Olexa9dra/stm32-binary-clock/docs/board_photos/power_and_stm32_back.jpg

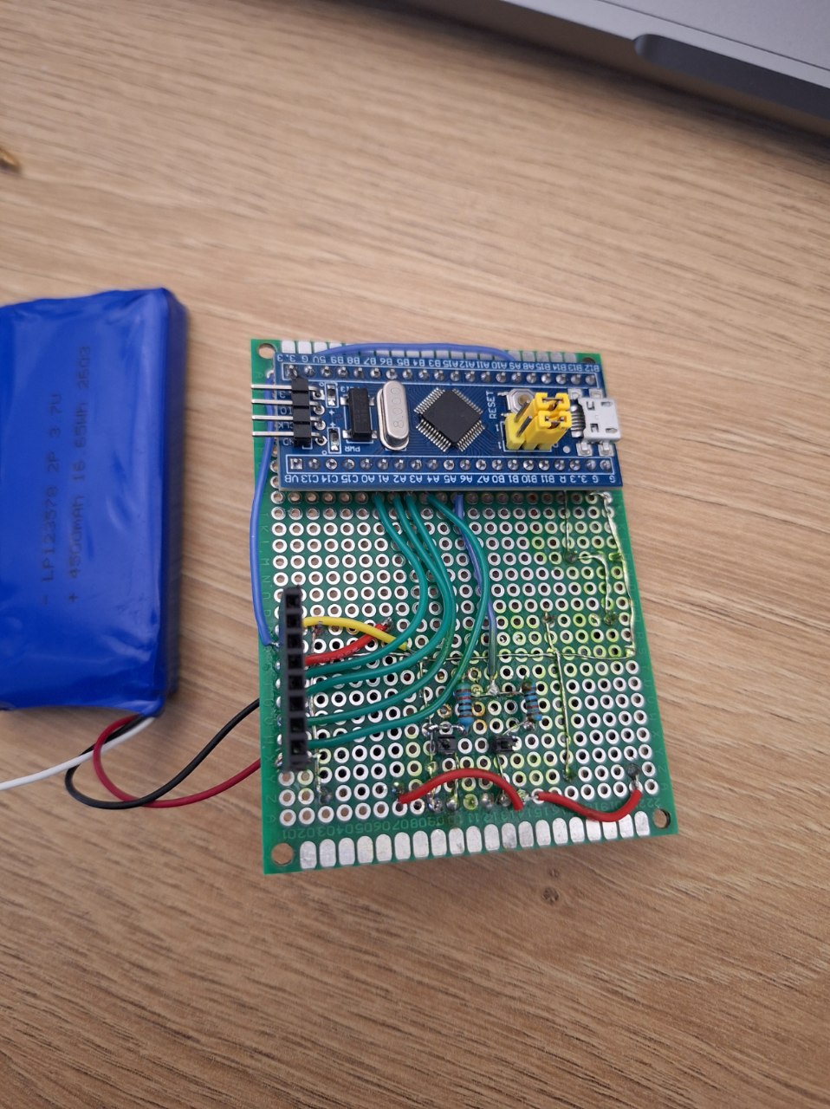
docs/board_photos/power_and_stm32_back.jpg
