Olexa9dra/stm32-binary-clock/docs/board_photos/periphery_front.jpg

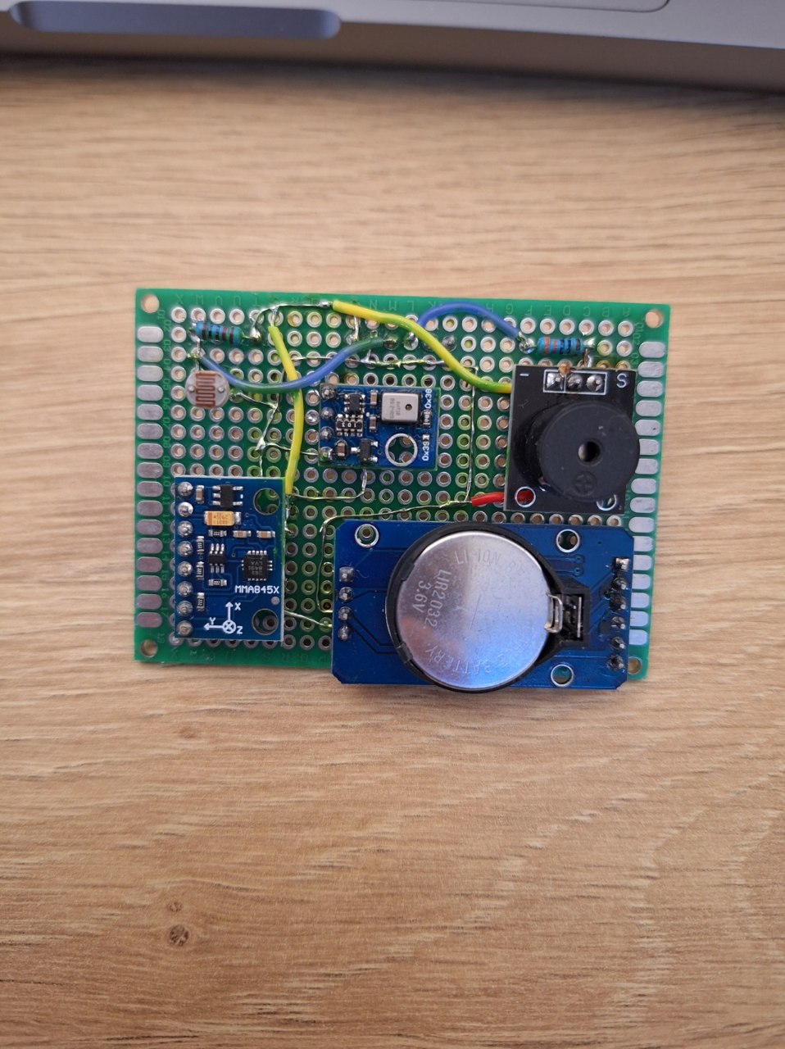
docs/board_photos/periphery_front.jpg
