Olexa9dra/stm32-binary-clock/docs/freecad_model.png

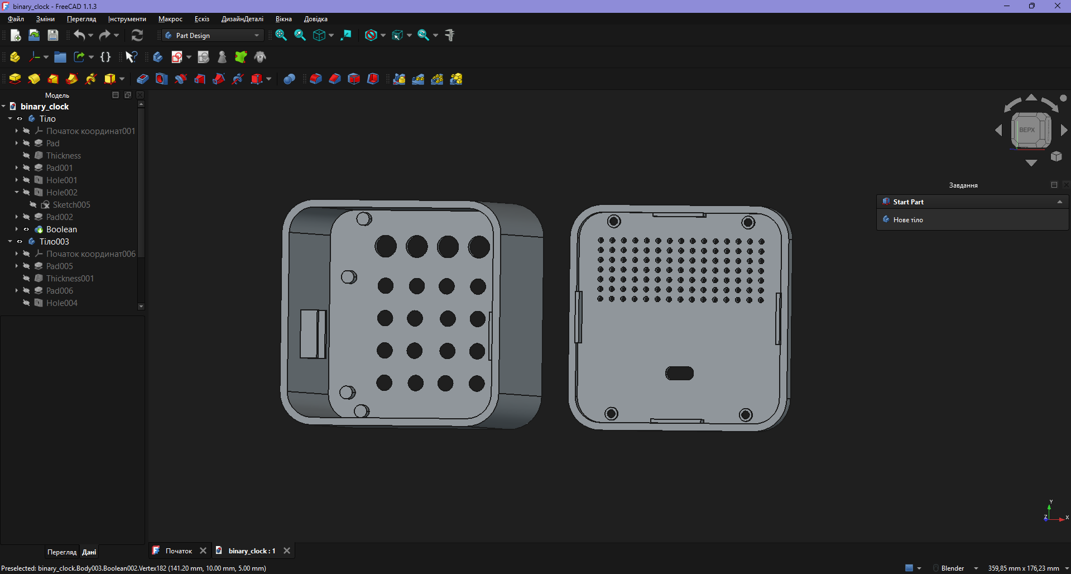
docs/freecad_model.png
