Olexa9dra/stm32-binary-clock/docs/kicad_schemes.png

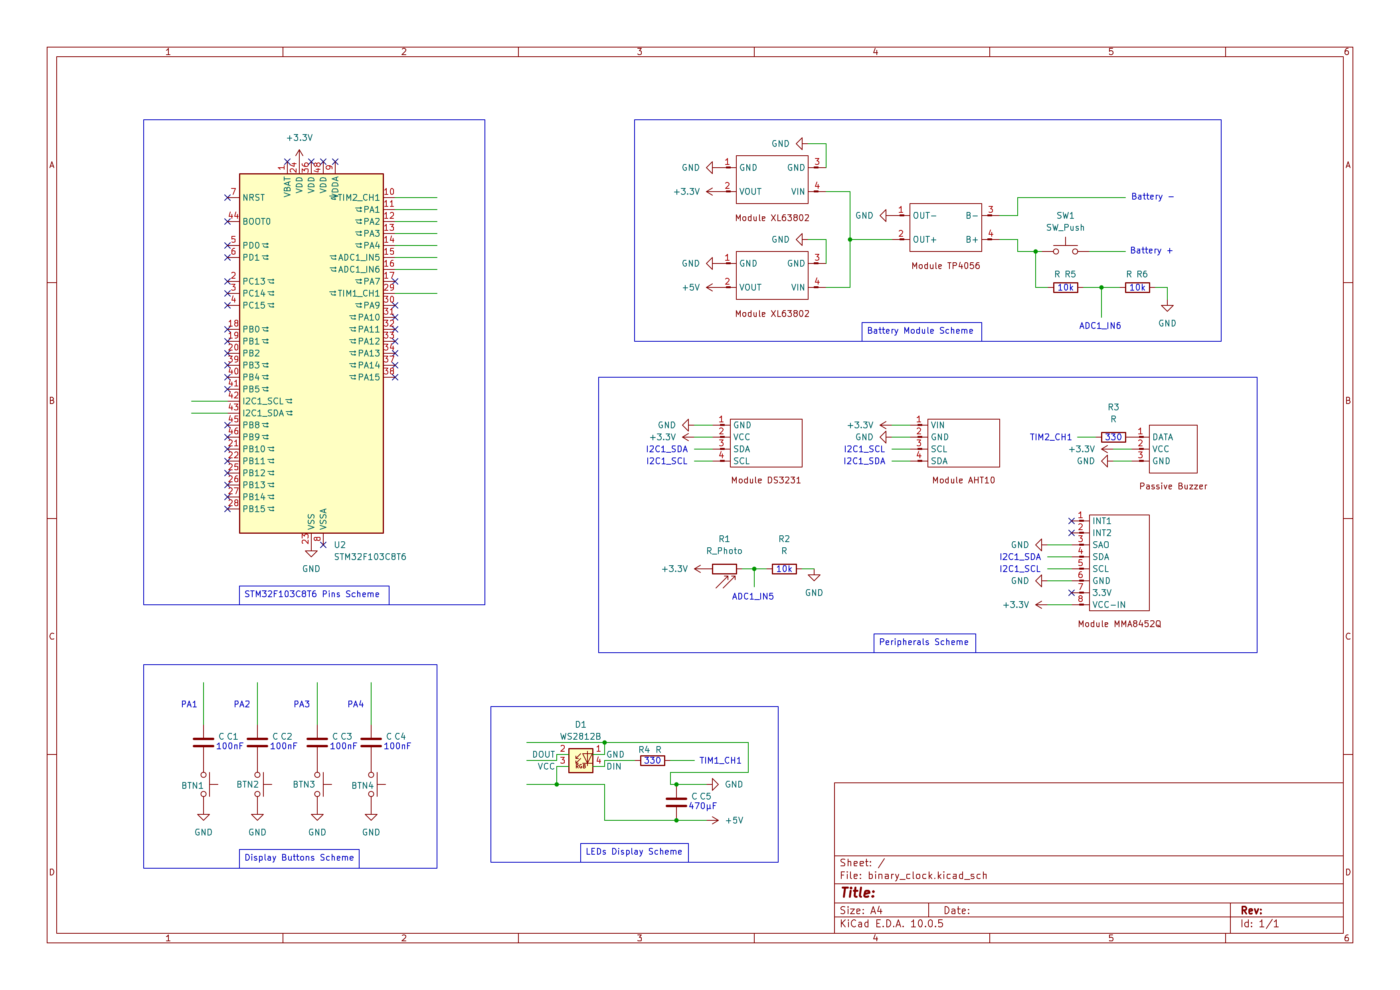
docs/kicad_schemes.png
