Olexa9dra/stm32-binary-clock/BinaryClock-F103.ioc

Mcu.UserName=STM32F103C8Tx
PA0-WKUP.Signal=S_TIM2_CH1_ETR
PA1.Signal=GPIO_Input
PA13.Signal=SYS_JTMS-SWDIO
PA14.Signal=SYS_JTCK-SWCLK
PA2.Signal=GPIO_Input
PA3.Signal=GPIO_Input
PA4.Signal=GPIO_Input
PA5.Signal=ADCx_IN5
PA6.Signal=ADCx_IN6
PA8.Signal=S_TIM1_CH1
PB6.Signal=I2C1_SCL
PB7.Signal=I2C1_SDA
