Olexa9dra/stm32-binary-clock/Drivers_Custom/Inc/light_sensor.h

#ifndef LIGHT_SENSOR_H
#define LIGHT_SENSOR_H

#include <stdint.h>

#define ADC_MIN 800
#define ADC_MAX 2500
#define BRIGHTNESS_MIN 2
#define BRIGHTNESS_MAX 20
#define UPDATE_DELAY_MS 100
#define ADC_POLL_TIMEOUT_MS 1U
#define BRIGHTNESS_HYSTERESIS 10

void LightSensor_Init(void);
void LightSensor_Update(void);
uint8_t LightSensor_GetBrightness(void);

#endif
