Olexa9dra/stm32-binary-clock/Modules/Inc/environment.h

#ifndef __ENVIRONMENT_H
#define __ENVIRONMENT_H

#include <stdint.h>

#define ENVIRONMENT_UPDATE_INTERVAL_MS 30000U

void Environment_Init(void);
void Environment_Update(void);
uint16_t Environment_GetDisplayValue(void);

#endif
