Olexa9dra/stm32-binary-clock/Modules/Src/battery.c

#include "battery.h"
#include "battery_driver.h"

static uint16_t batteryAdcValue = 0;
static float batteryVoltage = 0.0f;
static uint8_t batteryPercentage = 0;
static uint32_t lastUpdate = 0;
static uint8_t initialized = 0;

static uint8_t Battery_CalcPercentageFromVoltage(float voltage);

void Battery_Init(void) {
  if (BatteryDriver_ReadADC(&batteryAdcValue) != HAL_OK)
    return;

  initialized = 1;

  batteryVoltage = (batteryAdcValue / BATTERY_ADC_MAX) * BATTERY_ADC_REFERENCE *
                   BATTERY_DIVIDER_RATIO;

  batteryPercentage = Battery_CalcPercentageFromVoltage(batteryVoltage);
}

void Battery_Update(void) {
  uint32_t now = HAL_GetTick();

  if (now - lastUpdate < BATTERY_UPDATE_DELAY_MS)
    return;

  lastUpdate = now;

  uint16_t newAdcValue;

  if (BatteryDriver_ReadADC(&newAdcValue) != HAL_OK)
    return;

  if (!initialized) {
    batteryAdcValue = newAdcValue;
    initialized = 1;
  } else {
    batteryAdcValue = (batteryAdcValue * 3 + newAdcValue) / 4;
  }

  batteryVoltage = (batteryAdcValue / BATTERY_ADC_MAX) * BATTERY_ADC_REFERENCE *
                   BATTERY_DIVIDER_RATIO;

  uint8_t newPercentage = Battery_CalcPercentageFromVoltage(batteryVoltage);

  uint8_t difference;

  if (newPercentage > batteryPercentage)
    difference = newPercentage - batteryPercentage;
  else
    difference = batteryPercentage - newPercentage;

  if (difference > BATTERY_PERCENTAGE_HYSTERESIS)
    batteryPercentage = newPercentage;
}

uint16_t Battery_GetDisplayValue(void) {
  uint8_t percentage = batteryPercentage;
  uint8_t hundreds = percentage / 100;
  uint8_t tens = (percentage / 10) % 10;
  uint8_t ones = percentage % 10;
  return (ones << 12) | (tens << 8) | (hundreds << 4);
}

static uint8_t Battery_CalcPercentageFromVoltage(float voltage) {
  if (voltage <= BATTERY_MIN_VOLTAGE)
    return 0;

  if (voltage >= BATTERY_MAX_VOLTAGE)
    return 100;

  return (uint8_t)(((voltage - BATTERY_MIN_VOLTAGE) /
                    (BATTERY_MAX_VOLTAGE - BATTERY_MIN_VOLTAGE)) *
                       100.0f +
                   0.5f);
}
