Olexa9dra/stm32-binary-clock/(commit log)

2026-08-07 Add custom led screen
2026-08-07 Add light sensor
2026-08-10 Add accelerometer for screen rotation, cleanup code
2026-08-11 Cleanup code and rearrange timers and pins
2026-08-11 Change board to STM32F103C8T6
2026-08-11 Board related fixes
2026-08-19 Cleanup not used files and drivers
2026-08-27 Update edit code for clock, alarm, date. Add better error input handling
    [alarm.c, alarm.h, binary_clock.c, binary_clock.h, buttons.c, buttons.h, date.c, date.h]
2026-08-27 Accelerometer calibration and mask changes
2026-08-27 Add battery level
2026-09-08 ACH1 reading channels bug fix
    [BinaryClock-F103.ioc, adc_utils.c, battery_driver.c, light_sensor.c, main.c]
2026-09-11 Change maximum battery voltage
2026-09-14 Fixing prod build leds bug
    [led.c, power_manager.c]
2026-09-21 Fix buttons bug related to sleep mode
    [buttons.c]
2026-09-28 Add board photos
