Olexa9dra/stm32-binary-clock/docs/board_photos/display_front.jpg

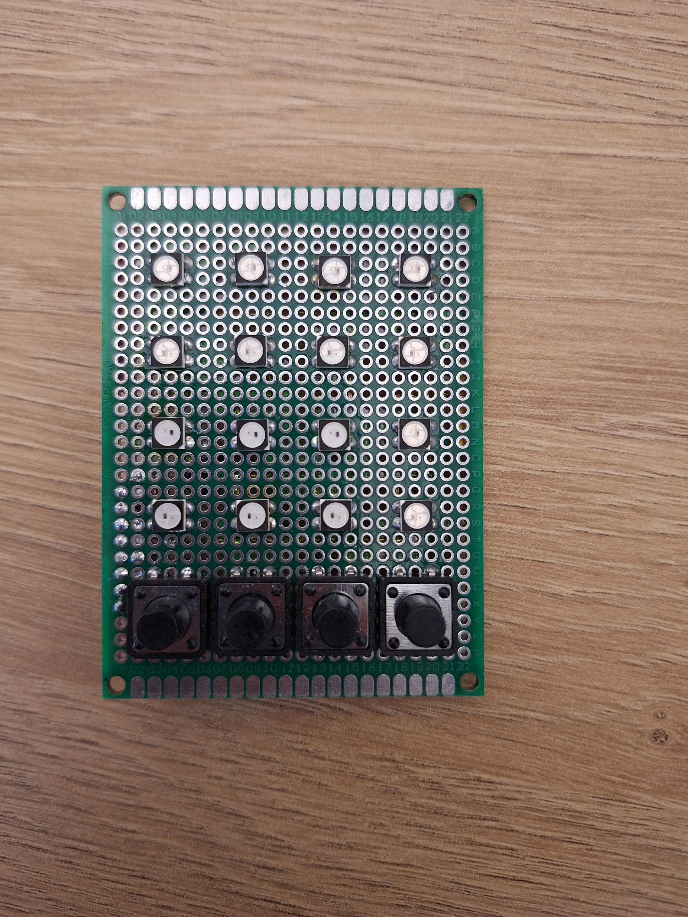
docs/board_photos/display_front.jpg
